bobbarnes1981/teensy_synth/images/pic_case_rear.jpg

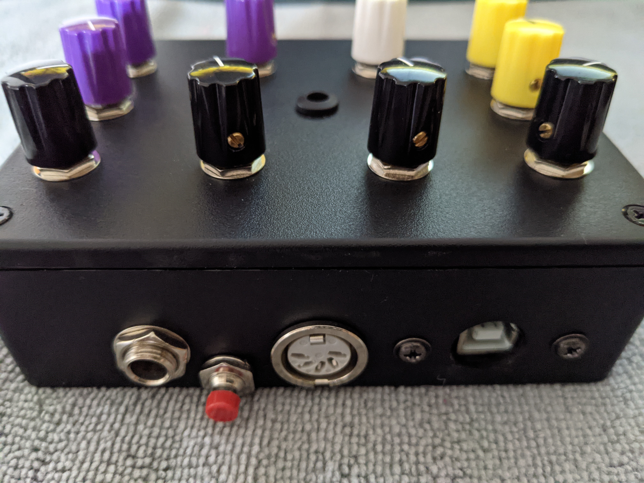
images/pic_case_rear.jpg
