bobbarnes1981/teensy_synth/images/kicad_pcb_0v5_back.png

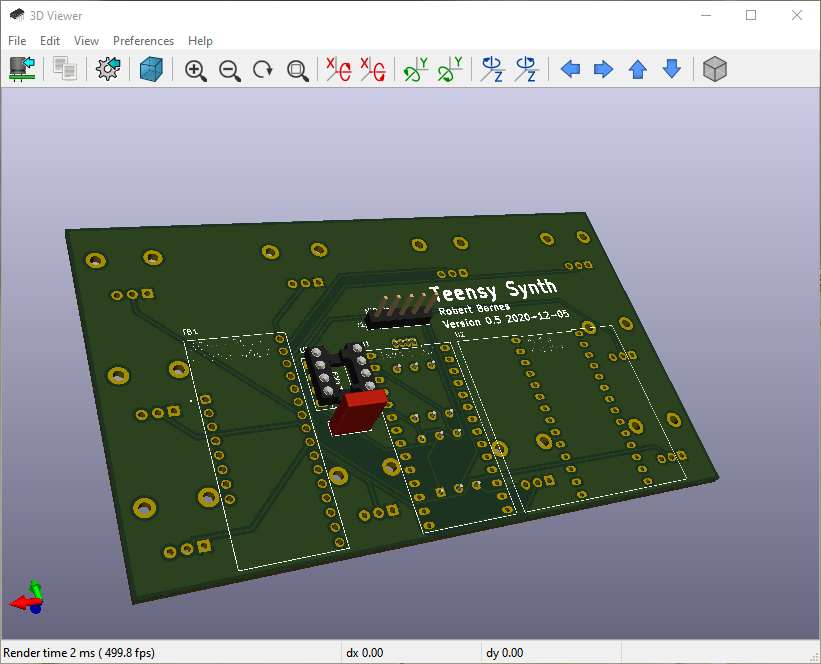
images/kicad_pcb_0v5_back.png
