bobbarnes1981/teensy_synth/images/pic_case_top.jpg

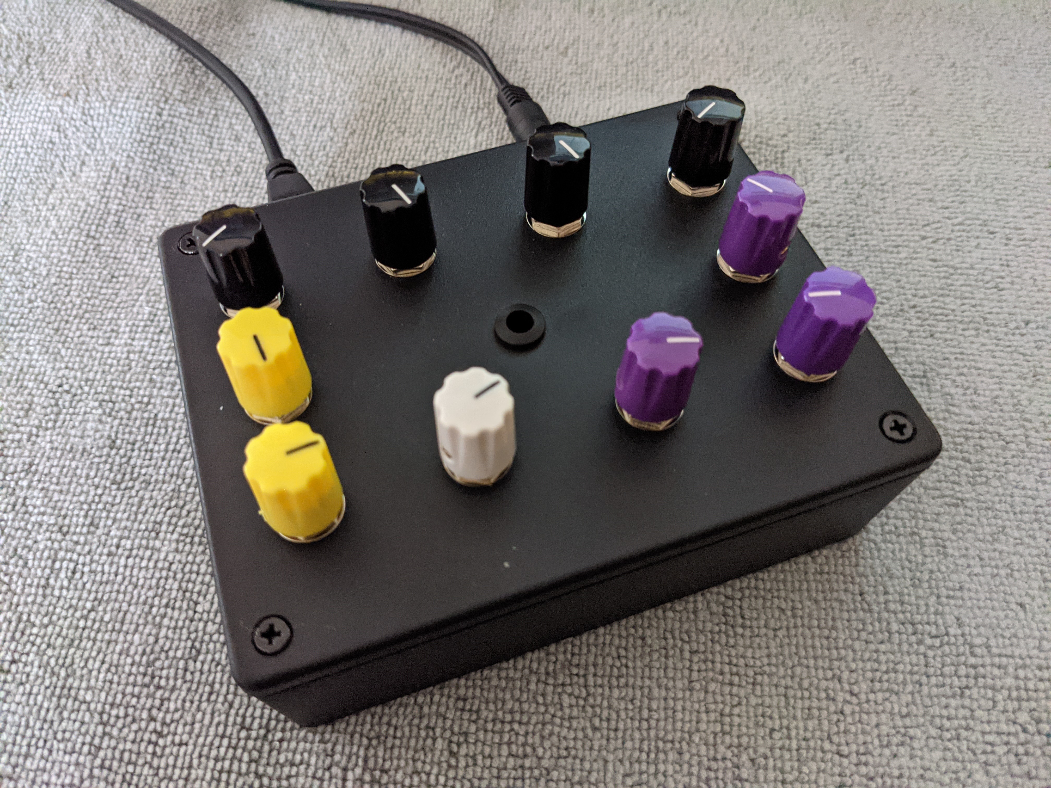
images/pic_case_top.jpg
