bobbarnes1981/teensy_synth/hardware/hardware.kicad_pcb

## KiCad design hardware/hardware.kicad_pcb (2021-01-05)

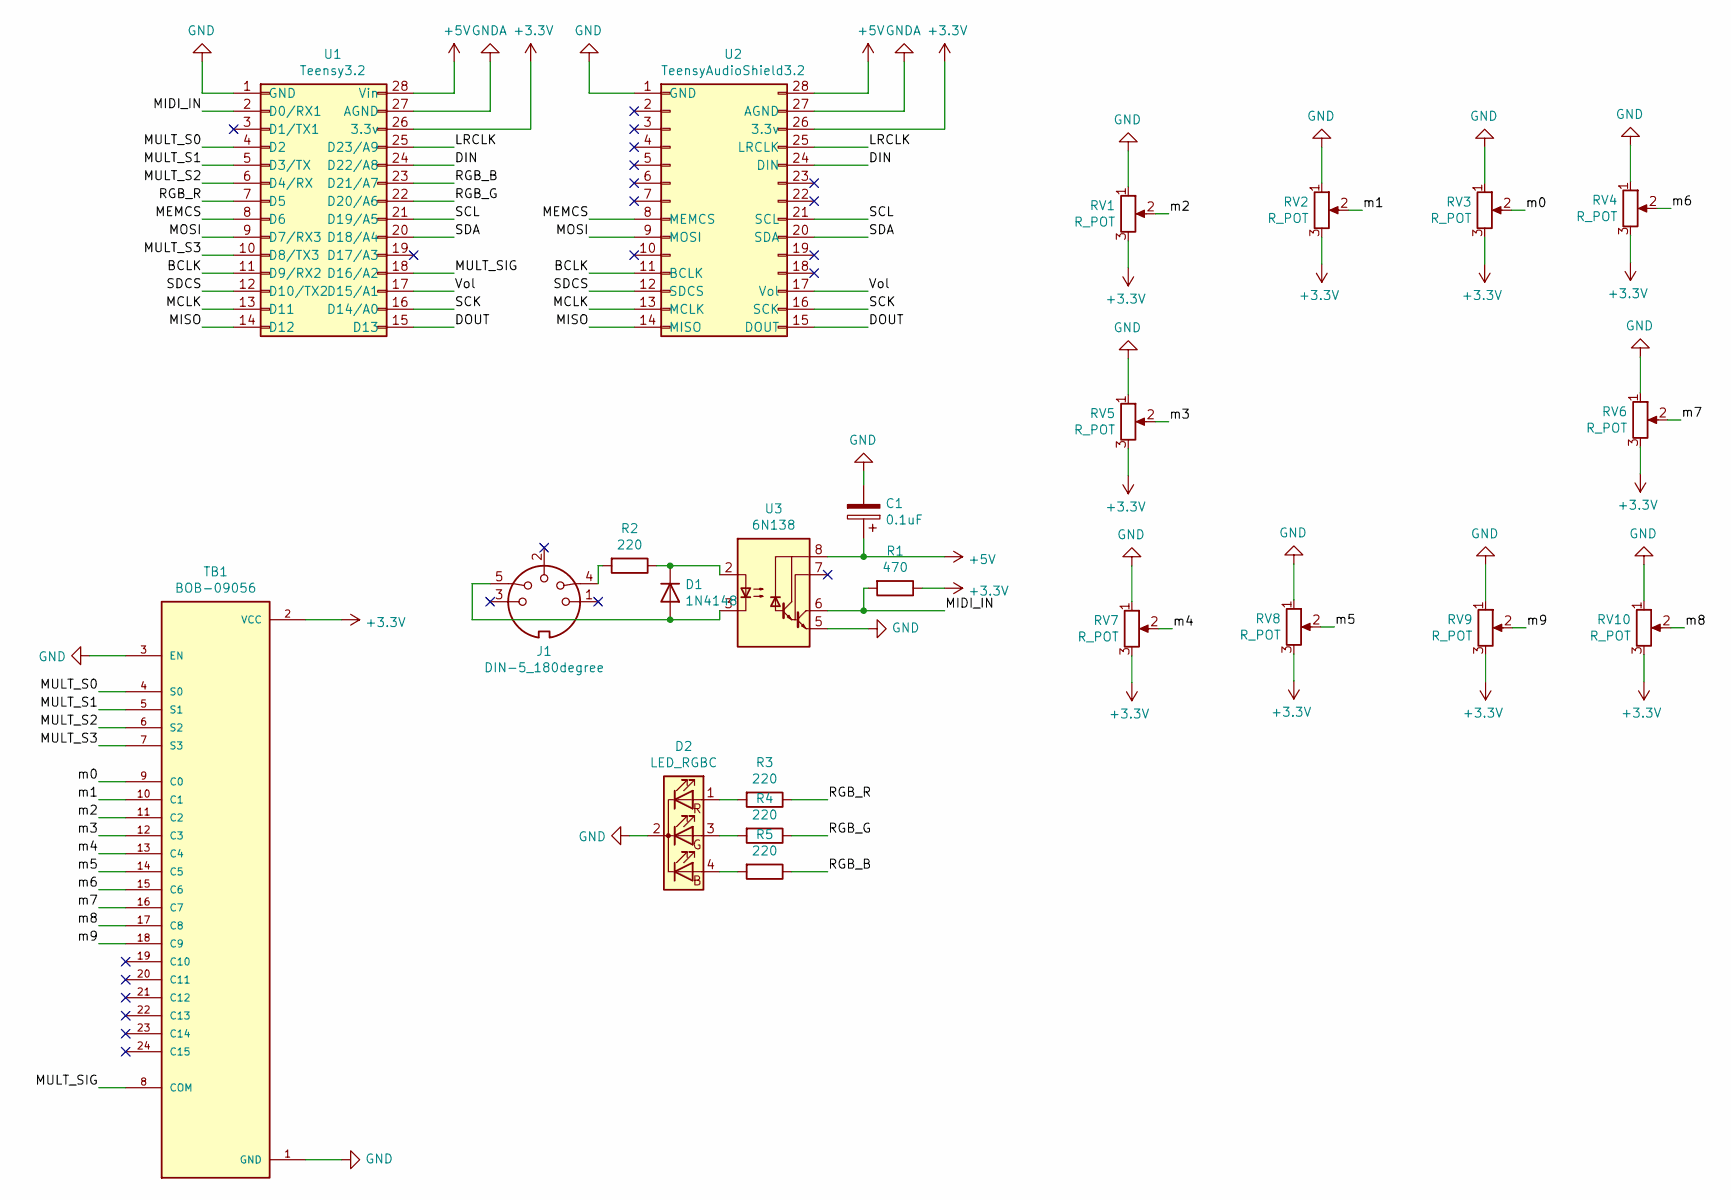
[picture p5: schematic hardware.sch]

Parts:
C1: 0.1uF; C_Rect_L7.0mm_W2.5mm_P5.00mm
D1: 1N4148; D_DO-35_SOD27_P10.16mm_Horizontal
D2: LED_RGBC; LED_D5.0mm-4_RGB
J1: DIN-5_180degree; PinHeader_1x05_P2.54mm_Vertical
R1: 470; R_Axial_DIN0207_L6.3mm_D2.5mm_P10.16mm_Horizontal
R2, R3, R4, R5: 220; R_Axial_DIN0207_L6.3mm_D2.5mm_P10.16mm_Horizontal
RV1, RV2, RV3, RV4, RV5, RV6, RV7, RV8, RV9, RV10: R_POT; Potentiometer_Alpha_RD901F-40-00D_Single_Vertical_CircularH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
TB1: BOB-09056; XDCR_BOB-09056; PARTREV N/A
U1: Teensy3.2
U2: TeensyAudioShield3.2; TeensyArduinoShield3.2
U3: 6N138; DIP-8_W7.62mm_Socket_LongPads

Connections:
+3V3: R1.1, RV1.3, RV2.3, RV3.3, RV4.3, RV5.3, RV6.3, RV7.3, RV8.3, RV9.3, RV10.3, TB1.2 (VCC), U1.26 (3.3v), U2.26 (3.3v)
+5V: C1.1, U1.28 (Vin), U2.28, U3.8 (VCC)
/BCLK: U1.11 (D9/RX2), U2.11 (BCLK)
/DIN: U1.24 (D22/A8), U2.24 (DIN)
/DOUT: U1.15 (D13), U2.15 (DOUT)
/LRCLK: U1.25 (D23/A9), U2.25 (LRCLK)
/MCLK: U1.13 (D11), U2.13 (MCLK)
/MEMCS: U1.8 (D6), U2.8 (MEMCS)
/MIDI_IN: R1.2, U1.2 (D0/RX1), U3.6 (VO2)
/MISO: U1.14 (D12), U2.14 (MISO)
/MOSI: U1.9 (D7/RX3), U2.9 (MOSI)
/MULT_S0: TB1.4 (S0), U1.4 (D2)
/MULT_S1: TB1.5 (S1), U1.5 (D3/TX)
/MULT_S2: TB1.6 (S2), U1.6 (D4/RX)
/MULT_S3: TB1.7 (S3), U1.10 (D8/TX3)
/MULT_SIG: TB1.8 (COM), U1.18 (D16/A2)
/RGB_B: R5.1, U1.23 (D21/A7)
/RGB_G: R4.1, U1.22 (D20/A6)
/RGB_R: R3.1, U1.7 (D5)
/SCK: U1.16 (D14/A0), U2.16 (SCK)
/SCL: U1.21 (D19/A5), U2.21 (SCL)
/SDA: U1.20 (D18/A4), U2.20 (SDA)
/SDCS: U1.12 (D10/TX2), U2.12 (SDCS)
/Vol: U1.17 (D15/A1), U2.17 (Vol)
/m0: RV3.2, TB1.9 (C0)
/m1: RV2.2, TB1.10 (C1)
/m2: RV1.2, TB1.11 (C2)
/m3: RV5.2, TB1.12 (C3)
/m4: RV7.2, TB1.13 (C4)
/m5: RV8.2, TB1.14 (C5)
/m6: RV4.2, TB1.15 (C6)
/m7: RV6.2, TB1.16 (C7)
/m8: RV10.2, TB1.17 (C8)
/m9: RV9.2, TB1.18 (C9)
GND: C1.2, D2.2 (K), RV1.1, RV2.1, RV3.1, RV4.1, RV5.1, RV6.1, RV7.1, RV8.1, RV9.1, RV10.1, TB1.1 (GND), TB1.3 (EN), U1.1 (GND), U2.1 (GND), U3.5 (GND)
GNDA: U1.27 (AGND), U2.27 (AGND)
unnamed: D1.1 (K), R2.1, U3.2 (C1)
unnamed: D1.2 (A), J1.5, U3.3 (C2)
unnamed: D2.1 (RA), R3.2
unnamed: D2.3 (GA), R4.2
unnamed: D2.4 (BA), R5.2
unnamed: J1.4, R2.2

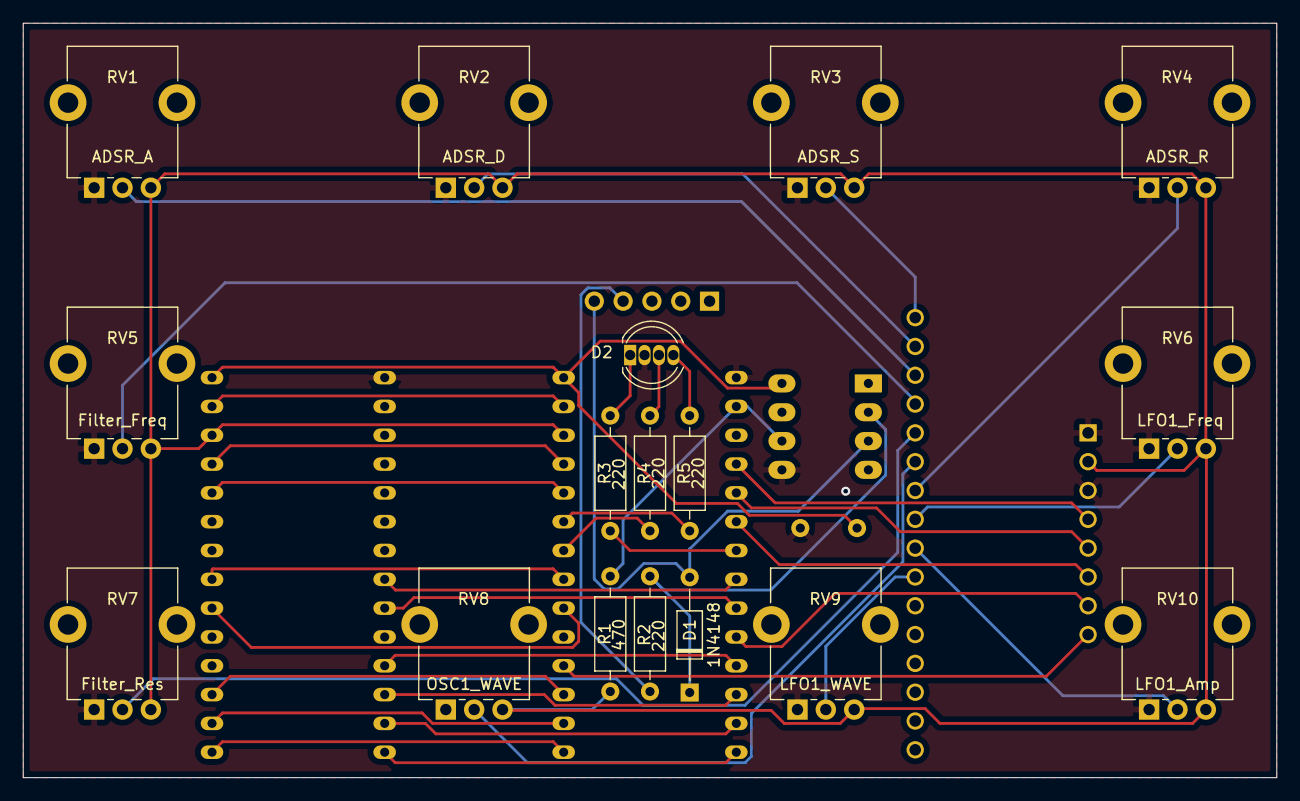
[picture p6: board hardware.kicad_pcb from above]

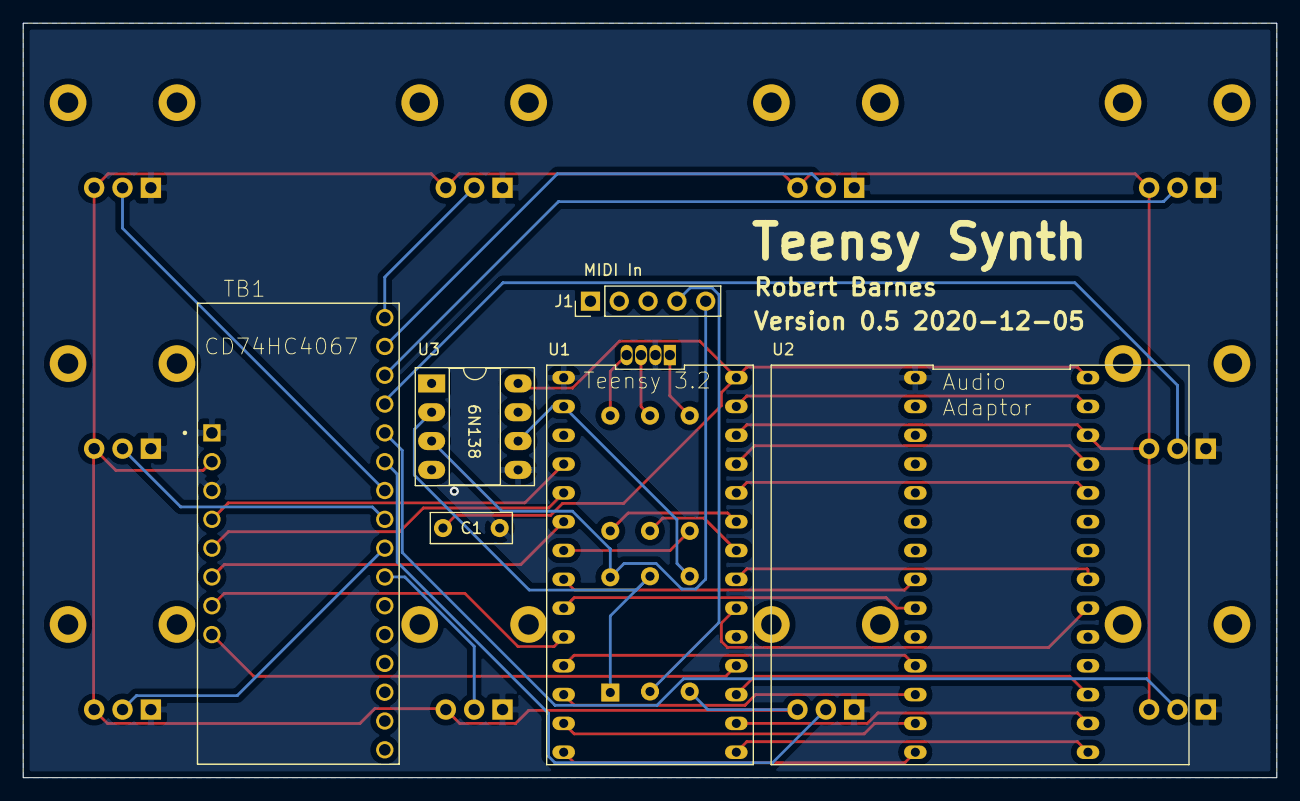
[picture p7: board hardware.kicad_pcb from below]

Board: 2 copper layers, 110.5 x 66.5 mm, 23 parts (6 on the bottom side), 42 nets.
