bobbarnes1981/teensy_synth/(commit log)

2020-11-17 Rename kicad project
    [hardware.kicad_pcb, hardware.sch]
2020-11-17 Add custom symbols/footprints for teensy and audio board
    [hardware.sch]
2020-11-17 Add midi connector footprint
    [hardware.kicad_pcb, hardware.sch]
2020-11-17 Prototype layout for pcb
    [hardware.kicad_pcb]
2020-11-18 Add some buttons and pots
    [hardware.kicad_pcb, hardware.sch]
2020-11-20 Schematic changes
    [hardware.sch]
2020-11-21 Lesson 6 - add filter
2020-11-21 Lesson 7 add pitch bend
2020-11-22 Add multiplexer and update pcb
    [hardware.kicad_pcb, hardware.sch]
2020-11-22 Layout pcb
    [hardware.kicad_pcb, hardware.sch]
2020-11-24 Update footprints
    [hardware.kicad_pcb, hardware.sch]
2020-11-24 Add image of kicad 2d model
2020-11-25 Add extra controls, convert pcb to use connectors
    [hardware.kicad_pcb, hardware.sch]
2020-11-27 Add panel idea
    [panel.kicad_pcb, panel.sch]
2020-11-30 Add 6n138 and pull down resistors to schematic
    [hardware.sch]
2020-11-30 Add pull-downs to pcb
    [hardware.kicad_pcb, hardware.sch]
2020-12-03 Remove MIDI out and add RGB LED header
    [hardware.kicad_pcb, hardware.sch]
2020-12-03 Move RGB_R and MULT address pins to get RGB on PWM pin
    [hardware.kicad_pcb, hardware.sch]
2020-12-04 Use old pin numbers for old pcb
2020-12-04 Implement wav buttons
2020-12-04 Add conditions for other pcb versions
2020-12-05 V0.5 PCB for Hammond case with pcb mount pots
    [hardware.kicad_pcb, hardware.sch]
2020-12-05 Redesign board to allow space for connectors
    [hardware.kicad_pcb, hardware.sch]
2020-12-05 Add text to silks
    [hardware.kicad_pcb]
2020-12-05 Remove panel, add measurements to PCB
    [hardware.kicad_pcb, panel.kicad_pcb, panel.sch]
2020-12-06 Change MIDI Out label to MIDI In
    [hardware.kicad_pcb]
2020-12-18 Switch to 0v5 config
2020-12-19 Make footprint match LED pinout even if schematic looks wrong
    [hardware.kicad_pcb, hardware.sch]
2020-12-19 Add test code for LED
2020-12-19 Just flash rgb colours untill we decide what the LED should indicate
2021-01-05 Use correct schematic diagram for RGB led
    [hardware.kicad_pcb, hardware.sch]
